StirlingMarketingGroup/coin-light-board/pcb/jlcpcb-bom.csv

Comment | Designator | Footprint | LCSC Part #
ATtiny202-SSNR | U1 | SOIC-8 | C2052951
MMBT3904 | Q1,Q2 | SOT-23 | C20526
10k 0603 | R3,R4 | 0603 | C25804
820R 0603 | R1 | 0603 | C23253
620R 0603 | R2 | 0603 | C23220
100nF 0603 | C1 | 0603 | C14663
Red LED 0805 NCD0805R1 | D1 | 0805 | C84256
Blue LED 0805 KT-0805B | D2 | 0805 | C2293
Push button 6x6x5mm TS-1102S-C-C-B | SW1 | SMD 6x6 | C381039
CR2032 holder MY-2032-08-R | BT1,BT2 | SMD | C964832
