StirlingMarketingGroup/coin-light-board/pcb/coin-light-board.kicad_pcb

## KiCad design pcb/coin-light-board.kicad_pcb (2026-11-11)

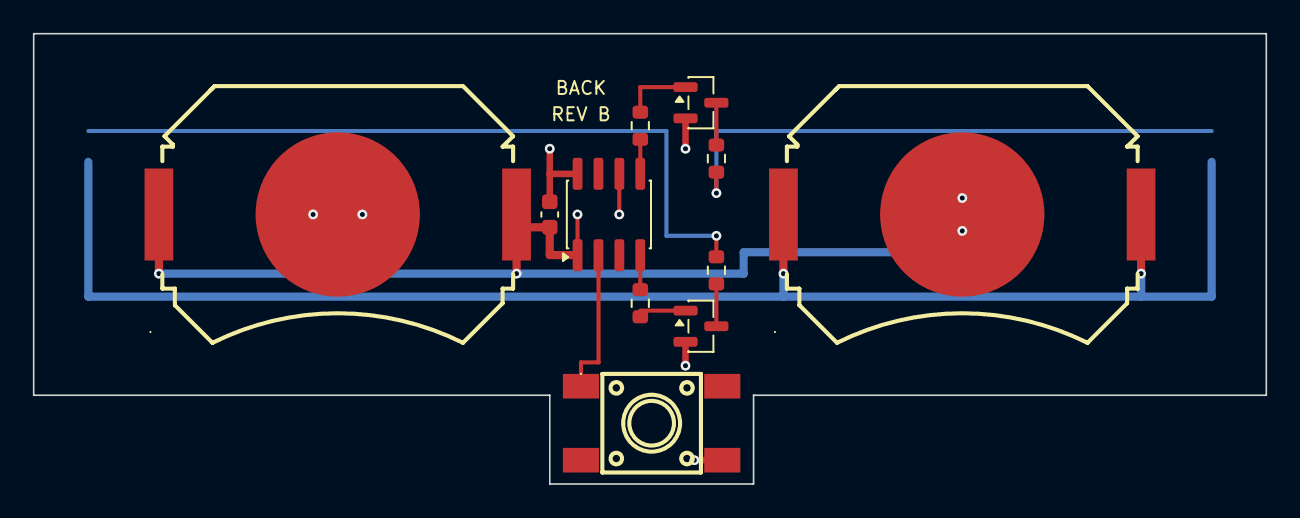
[picture p3: board coin-light-board.kicad_pcb from above]

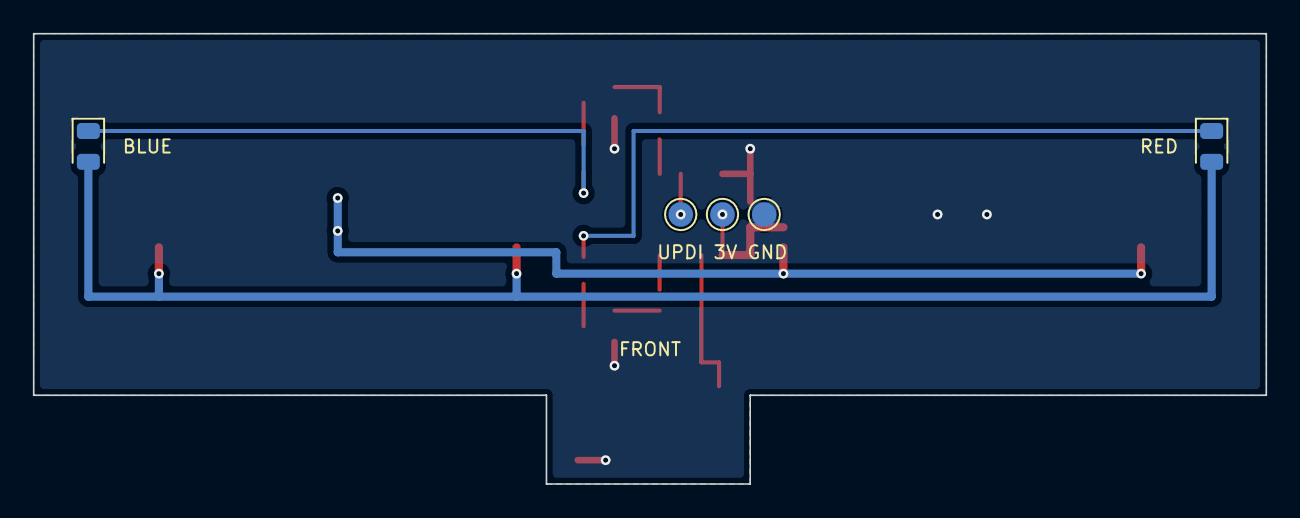
[picture p4: board coin-light-board.kicad_pcb from below]

Board: 2 copper layers, 75.0 x 27.4 mm, 16 parts (5 on the bottom side), 13 nets.

Parts:
BT1, BT2: CR2032; BAT-SMD_MY-2032-08
C1: 100nF; C_0603_1608Metric
D1: red; LED_0805_2012Metric
D2: blue; LED_0805_2012Metric
Q1, Q2: MMBT3904; SOT-23
R1: 820; R_0603_1608Metric
R2: 620; R_0603_1608Metric
R3, R4: 10k; R_0603_1608Metric
SW1: 6x6 tact; KEY-SMD_4P-L6.0-W6.0-P4.50-LS8.6
TP1: GND; TestPoint_Pad_D1.5mm
TP2: VDD; TestPoint_Pad_D1.5mm
TP3: UPDI; TestPoint_Pad_D1.5mm
U1: ATtiny202; SOIC-8_3.9x4.9mm_P1.27mm

Connections:
B1: Q1.1, R3.2
B2: Q2.1, R4.2
BK: D2.1, R2.1
BTN: SW1.1, U1.2
C1: Q1.3, R1.1
C2: Q2.3, R2.2
GND: BT1.2, C1.2, Q1.2, Q2.2, SW1.4, TP1.1, U1.8
PA1: R3.1, U1.4
PA2: R4.1, U1.5
RK: D1.1, R1.2
UPDI: TP3.1, U1.6
VLED: BT2.1, D1.2, D2.2
VMID: BT1.1, BT2.2, C1.1, TP2.1, U1.1
