StirlingMarketingGroup/coin-light-board/(commit log)

2026-11-11 Coin light board, revision A: board layout, firmware, and factory files
    A small board for inside a metal challenge coin. One button starts and stops
    a red and a blue LED that alternate at 2 Hz. ATtiny202, two CR2032 cells in
    series, one transistor per color. Designed and checked, not yet built.
    [coin-light-board.kicad_pcb, jlcpcb-bom.csv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]
2026-11-11 Revision B: 75 x 22 mm board with the LEDs under the coin's light windows
    The LEDs move to the front side, 68.35 mm apart, so each one sits under a
    light window and needs no wires. The batteries, chip and a 6 mm push button
    stay on the back side. The button sits on a tab below the middle of the board.
    The firmware now sleeps while the button is held down.
    Revision A is kept under the tag rev-a.
    [coin-light-board.kicad_pcb, jlcpcb-bom.csv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]
2026-11-11 Order package: every part has a JLCPCB number, with step-by-step ordering notes
    The battery holder and the button now use JLCPCB's own footprints for the
    exact parts ordered. The LEDs move to 0805, which JLCPCB stocks as standard.
    ORDERING.md lists each choice for the test order, and firmware.hex is the
    compiled firmware to load.
    No trace runs under a battery on the back side any more. The rim of a coin
    cell is its + side, so a ground connection there relied on solder mask alone.
    The button is wired on two diagonal pads, which works whichever way its
    inner contacts are paired.
    [coin-light-board.kicad_pcb, jlcpcb-bom.csv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]
